DS-567/AMD-AOHW25_620/Demonstrator/hw/PCBs/Motor Encoder Circuit/readme.md

#### Motor Encoder Circuit

Converts the 12V pulses from the rotary encoder to 3.3V which are connected to the FPGA. Test points provide oscilloscope access to the 12V encoder pulses for visualisation.

<p align="center">
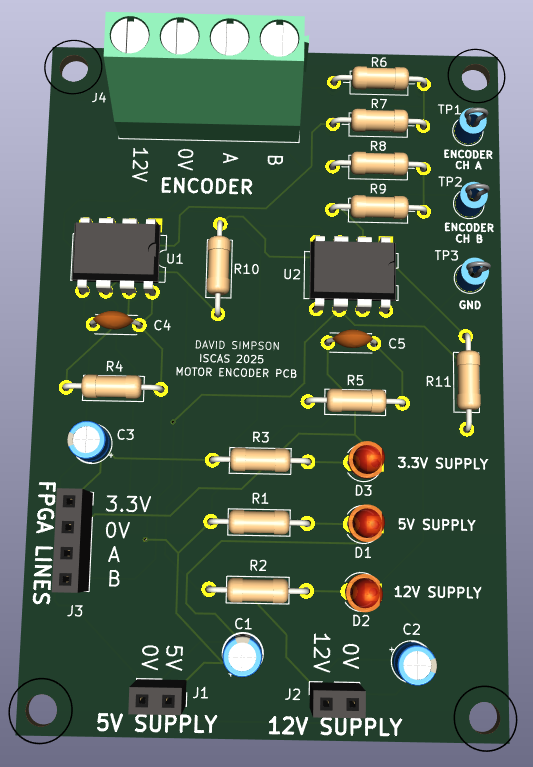
[picture p16: assets/motor_encoder_pcb_3D.PNG]
Motor Encoder pcb 3D
  
</p>

<p align="center">
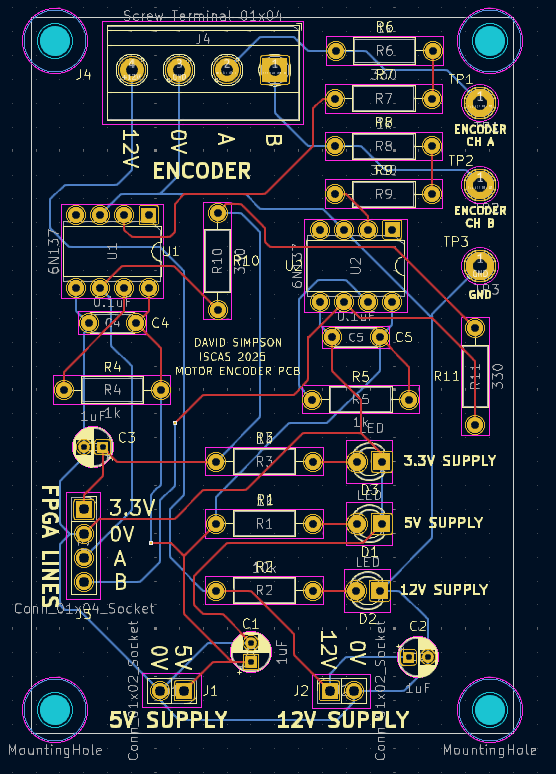
[picture p17: assets/motor_encoder_pcb.PNG]
Motor Encoder pcb
  
</p>
