DS-567/AMD-AOHW25_620/Demonstrator/hw/PCBs/Motor Control Circuit/Readme.md

#### Motor Control Circuit

Allows the user to start, stop and change the direction of the motor using the buttons. A 24-pulse rotary encoder provides motor speed control. LEDs indicates the directional status of motor control, i.e. forward and reveres and also the motor running status. These are all connected to GPIO on the RISC-V processor (Neorv32).

<p align="center">
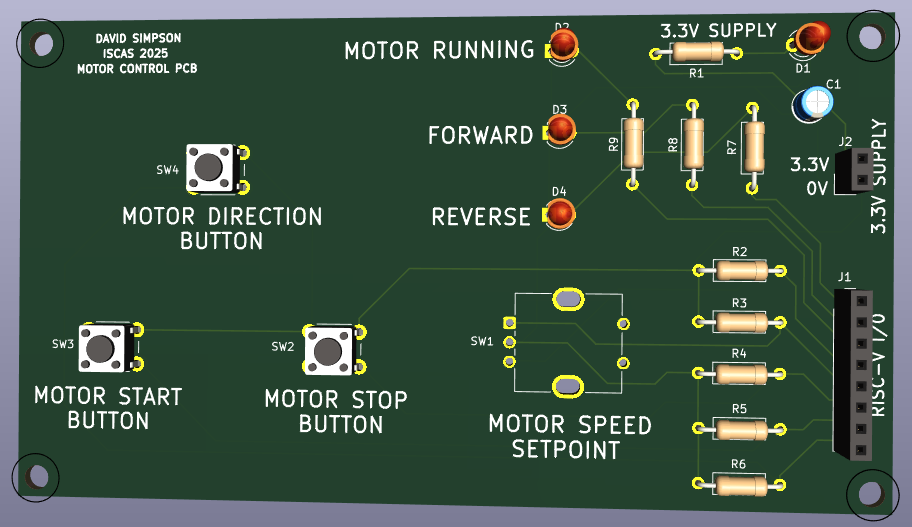
[picture p18: assets/motor_control_pcb_3D.PNG]
Motor Control pcb 3D
  
</p>

<p align="center">
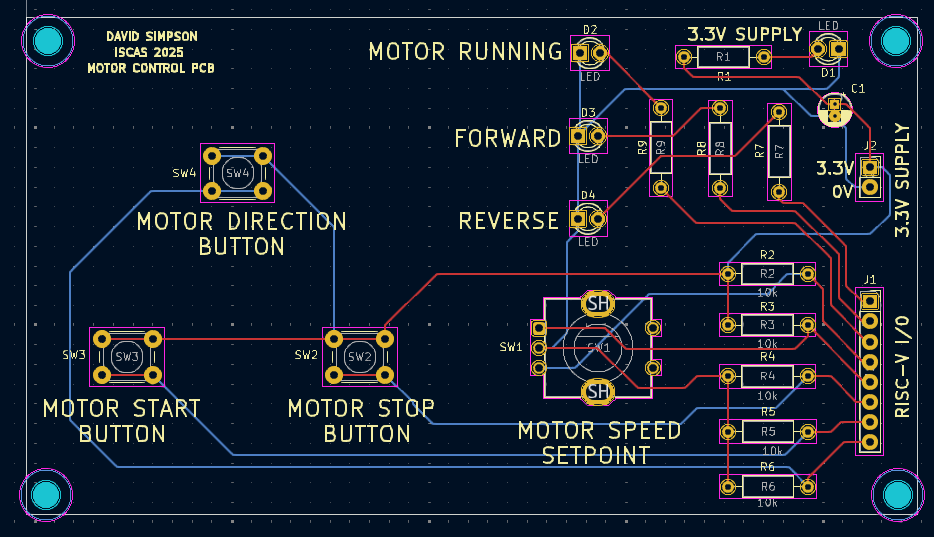
[picture p19: assets/motor_control_pcb.PNG]
Motor Control pcb
  
</p>
