DS-567/AMD-AOHW25_620/Presentation_David_Simpson.pdf

## From Brain-Inspiration to Silicon-Realisation: SNN-based Smart Watchdogs for RISC-V Fault Detection

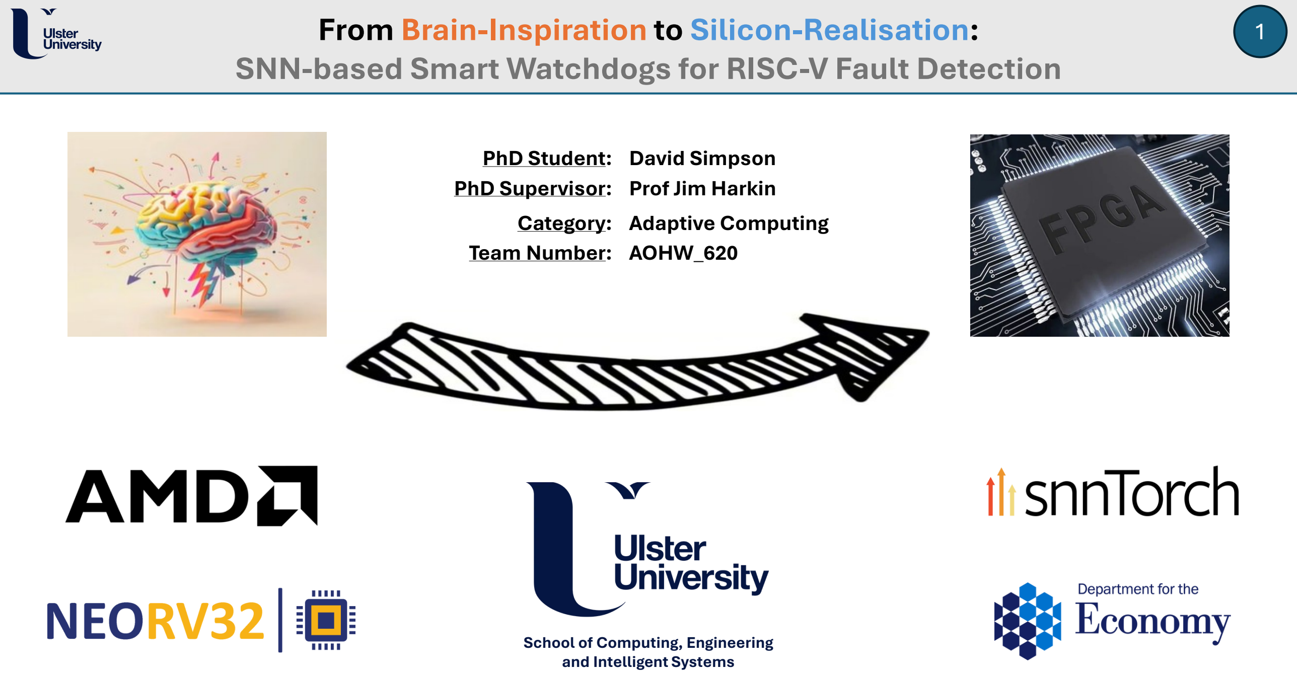
[picture p52: page 1]

1

PhD Student:
PhD Supervisor:
Category:
Team Number:

School of Computing, Engineering and Intelligent Systems

David Simpson
Prof Jim Harkin
Adaptive Computing
AOHW_620

Background and Motivation | 2

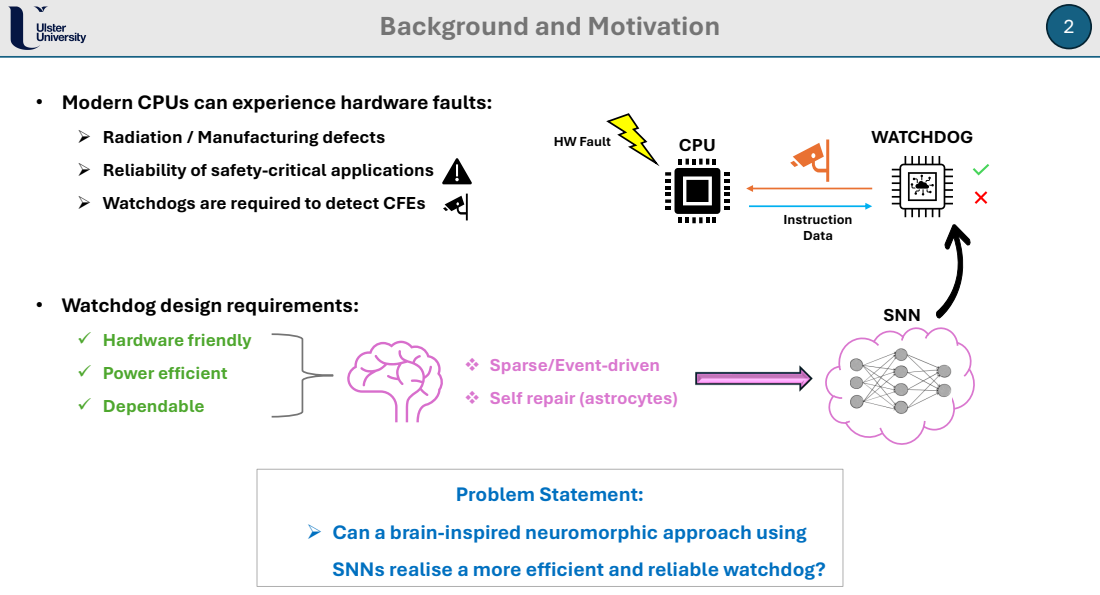
[picture p53: page 2]
HW Fault; CPU; WATCHDOG; Problem Statement:; Instruction Data; SNN

• Modern CPUs can experience hardware faults:
➢ Radiation / Manufacturing defects
➢ Reliability of safety-critical applications
➢ Watchdogs are required to detect CFEs

• Watchdog design requirements:
✓ Hardware friendly
✓ Power efficient
✓ Dependable

❖ Sparse/Event-driven
❖ Self repair (astrocytes)

➢ Can a brain-inspired neuromorphic approach using
SNNs realise a more efficient and reliable watchdog?

Proposed Solution: Smart Watchdogs | 3

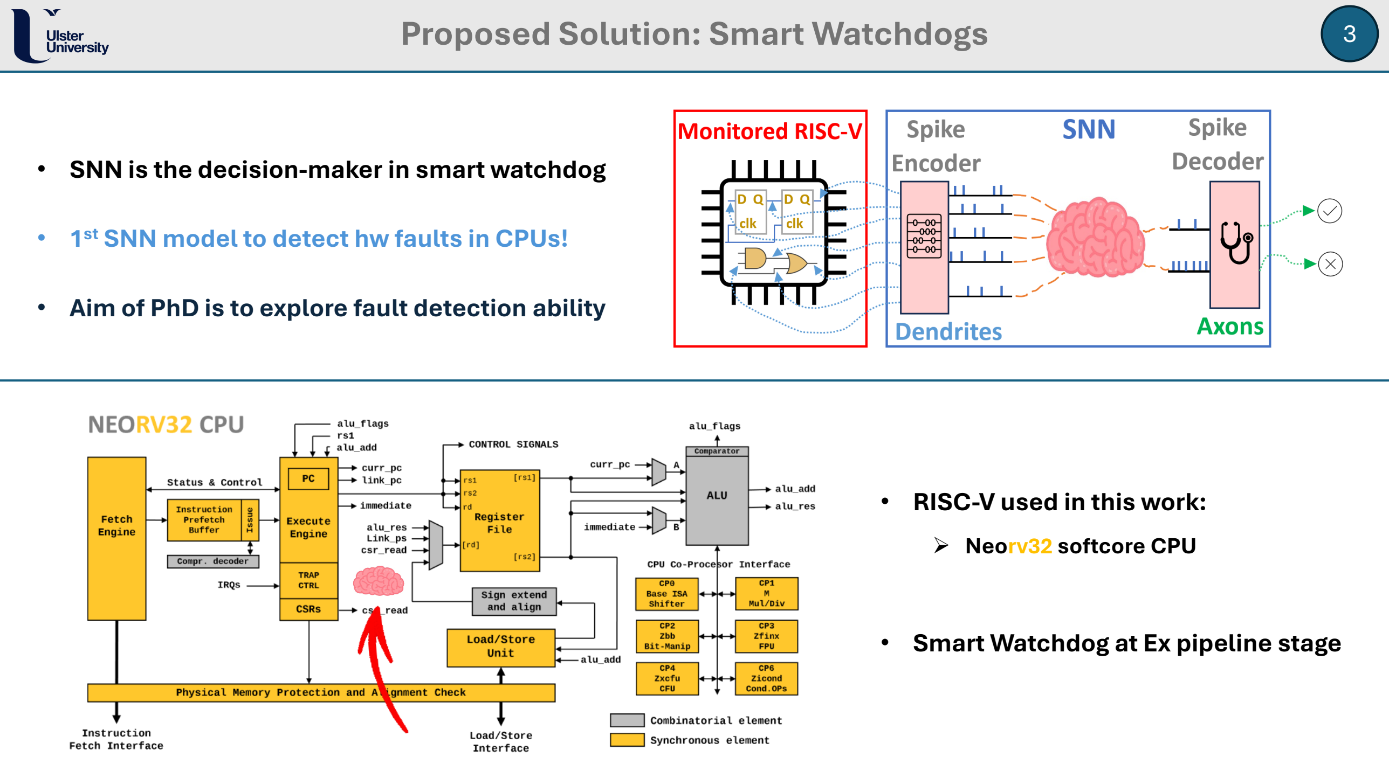
[picture p54: page 3]

- SNN is the decision-maker in smart watchdog
- RISC-V used in this work:
- Neorv32 softcore CPU
- Aim of PhD is to explore fault detection ability
- Smart Watchdog at Ex pipeline stage
- 1

st SNN model to detect hw faults in CPUs!

## Methodology

4

•

8

- Stage Methodology in this PhD ➢ Complete ML Workflow

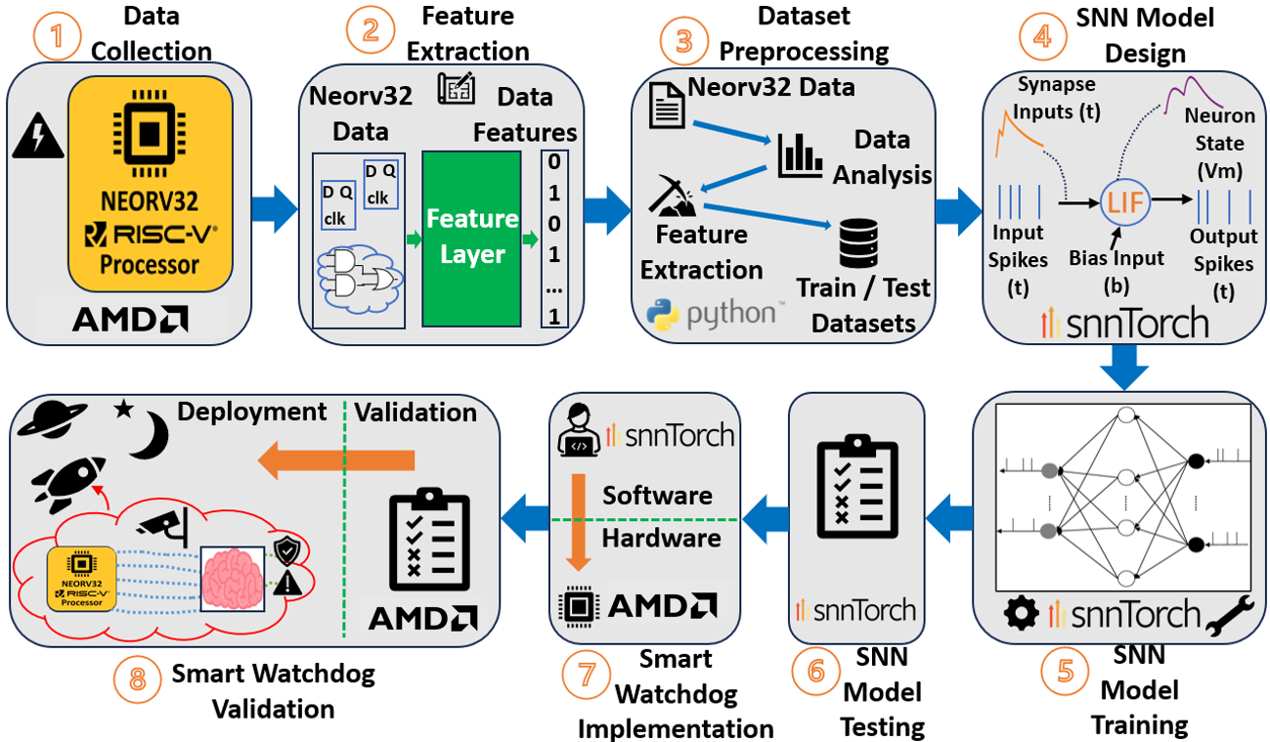
[picture p55: figure]

Key Stages: Data Collection and SNN Model Development | 5

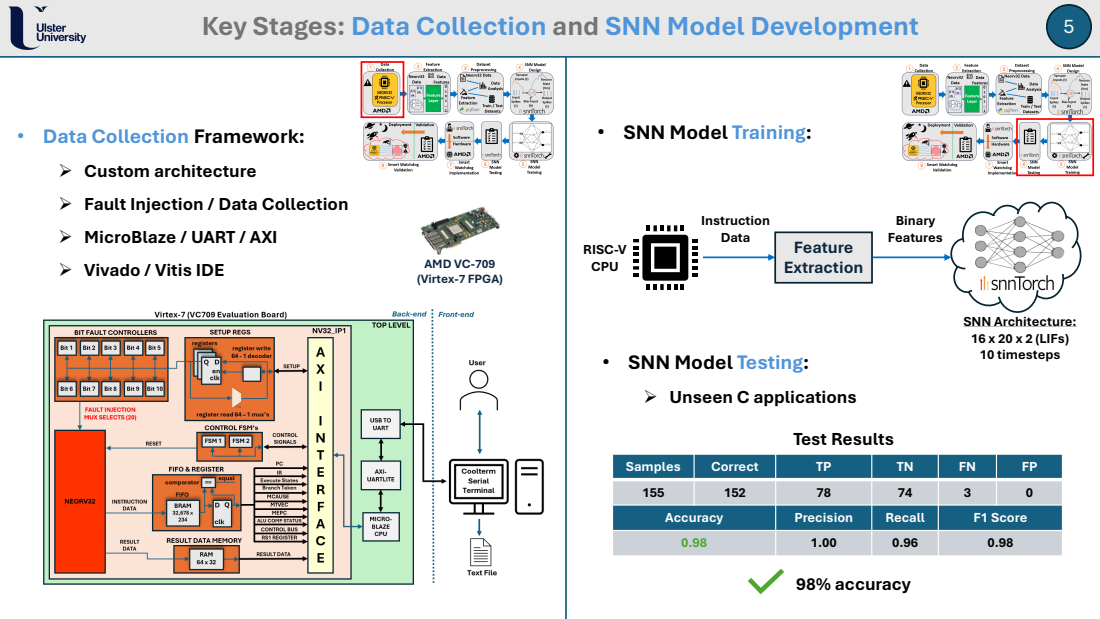
[picture p56: page 5]
➢ Vivado / Vitis IDE; AMD VC-709; (Virtex-7 FPGA); Instruction Data; RISC-V CPU; Feature Extraction; Binary Features; Test Results; 98% accuracy; SNN Architecture: 16 x 20 x 2 (LIFs) 10 timesteps

• Data Collection Framework:
➢ Custom architecture
➢ Fault Injection / Data Collection
➢ MicroBlaze / UART / AXI

• SNN Model Training:

• SNN Model Testing:
➢ Unseen C applications

Samples | Correct | TP | TN | FN | FP
155 | 152 | 78 | 74 | 3 | 0
Accuracy | | Precision | Recall | F1 Score
0.98 | | 1.00 | 0.96 | 0.98

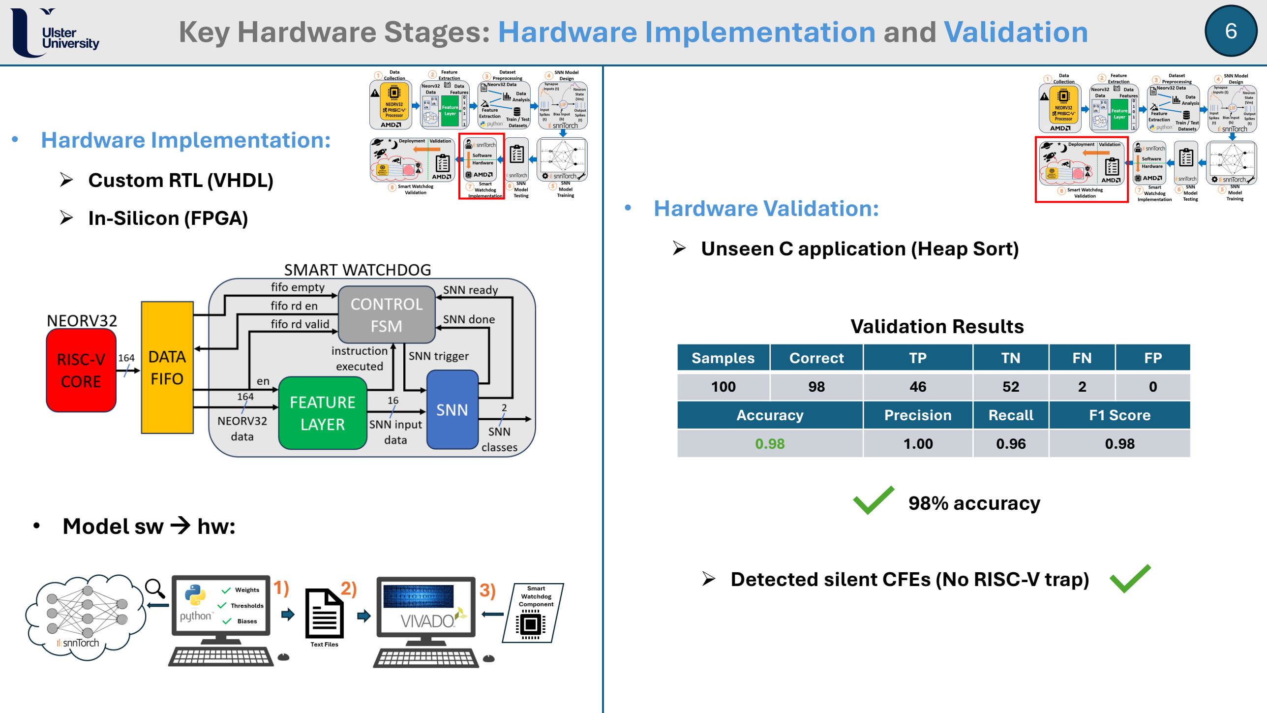
[picture p57: figure]
• Hardware Implementation:; ➢ Custom RTL (VHDL) ➢ In-Silicon (FPGA); Samples; Correct; Accuracy; Precision; Recall; F1 Score; • Model sw → hw:; • Hardware Validation:; ➢ Unseen C application (Heap Sort); Validation Results; 98% accuracy; ➢ Detected silent CFEs (No RISC-V trap)

Key Hardware Stages: Hardware Implementation and Validation | 6

Key Hardware Stages: Demonstrator | 7

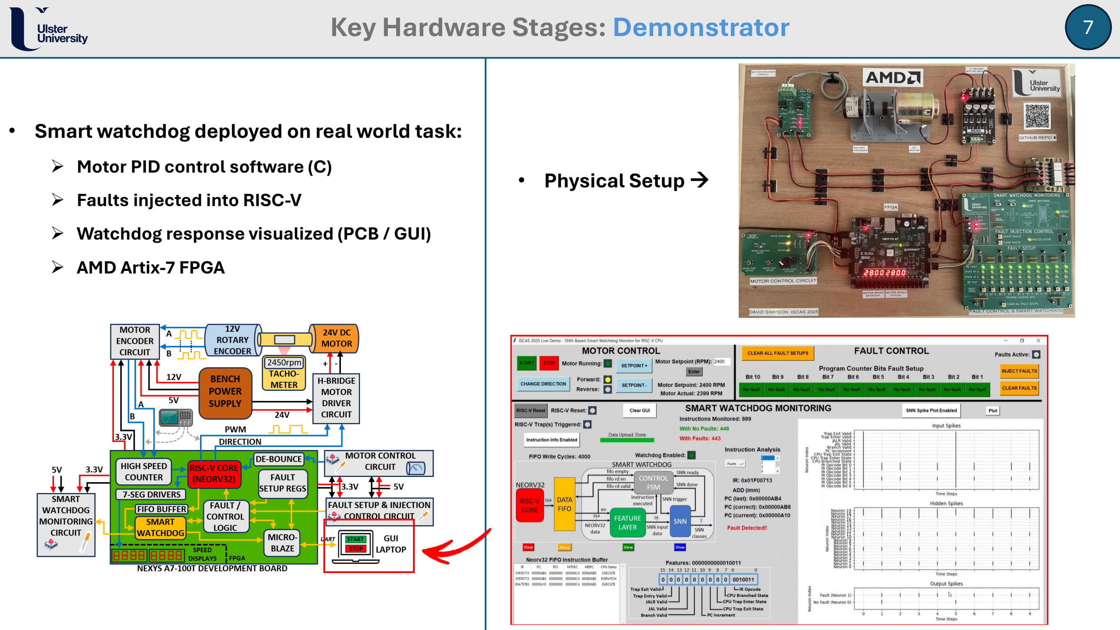
[picture p58: page 7]

- Smart watchdog deployed on real world task:
- Motor PID control software (C)
- Faults injected into RISC-V
- Watchdog response visualized (PCB / GUI)
- AMD Artix-7 FPGA
- Physical Setup →
- Vivado Block Diagram →

PPA / Summary / Future Work | 8

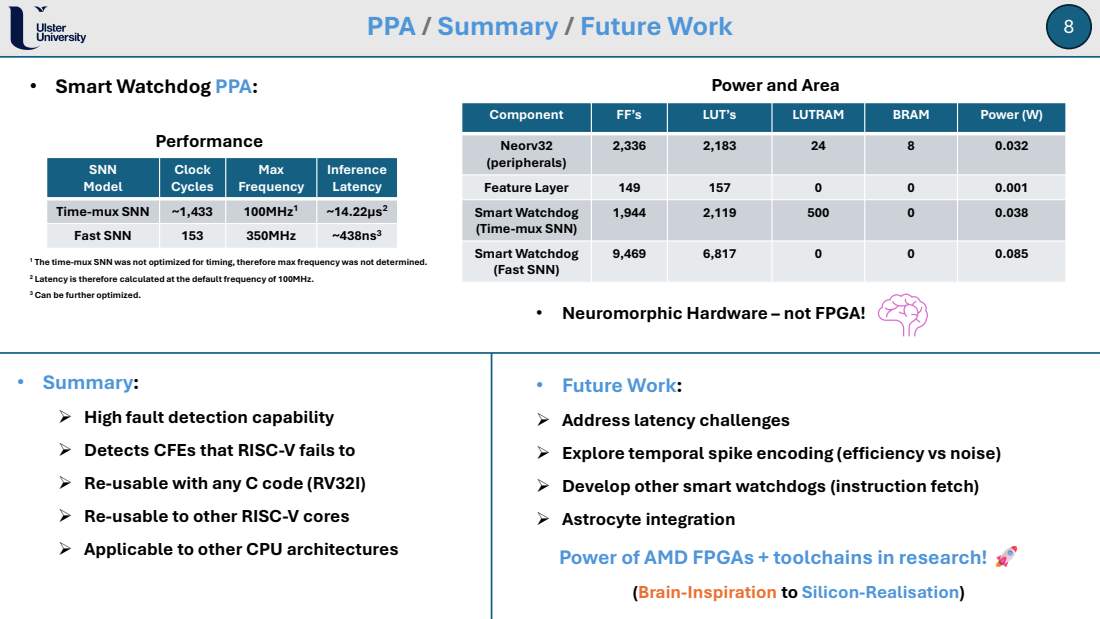
[picture p59: page 8]
Time-mux SNN; 100MHz¹; ~14.22µs²; Fast SNN; 350MHz; ~438ns³; Performance

• Smart Watchdog PPA:

Power and Area

Component | FF’s | LUT’s | LUTRAM | BRAM | Power (W)
Neorv32 (peripherals) | 2,336 | 2,183 | 24 | 8 | 0.032

SNN Model | Clock Cycles | Max Frequency | Inference Latency

Feature Layer | 149 | 157 | 0 | 0 | 0.001

Smart Watchdog
(Time-mux SNN)
(Fast SNN)
• Neuromorphic Hardware – not FPGA!

1 The time-mux SNN was not optimized for timing, therefore max frequency was not determined.
2 Latency is therefore calculated at the default frequency of 100MHz.
3 Can be further optimized.

• Summary:
➢ High fault detection capability
➢ Detects CFEs that RISC-V fails to
➢ Re-usable with any C code (RV32I)
➢ Re-usable to other RISC-V cores
➢ Applicable to other CPU architectures

• Future Work:
➢ Address latency challenges
➢ Explore temporal spike encoding (efficiency vs noise)
➢ Develop other smart watchdogs (instruction fetch)
➢ Astrocyte integration
Power of AMD FPGAs + toolchains in research!

(Brain-Inspiration to Silicon-Realisation)

## Time for Questions ?

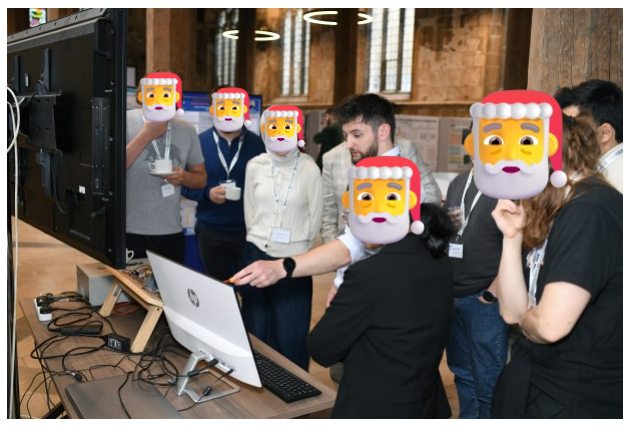
[picture p60: figure]
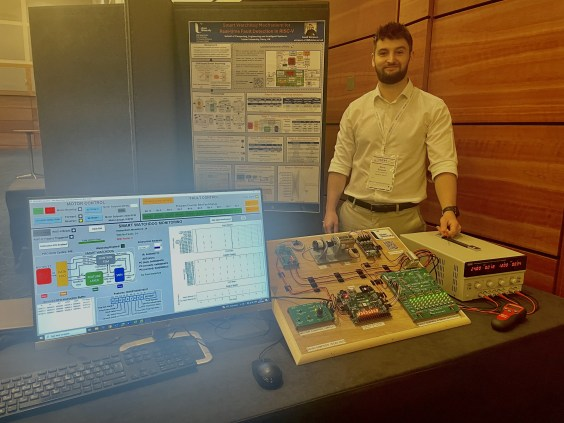
[picture p61: figure]

IEEE ISCAS 2025

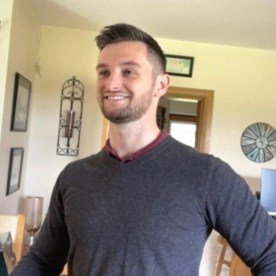
[picture p62: figure]

International
Workshop on
Reliable and
Sustainable
Neuromorphic
Hardware 2025

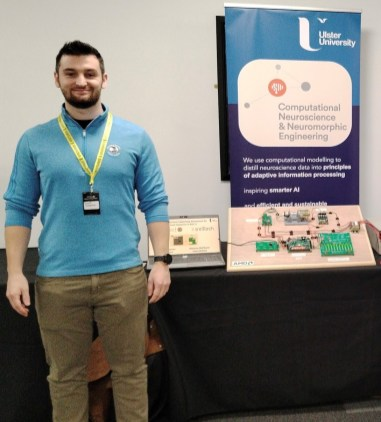
[picture p63: figure]

AMD / eFutures
Edge AI 2024

Contacts:

simpson-d12@ulster.ac.uk

David Simpson | LinkedIn (https://www.linkedin.com/in/david-simpson-040189221/)

Github repo:DS- (https://github.com/DS-567/AMD-AOHW25_620)567/AMD- (https://github.com/DS-567/AMD-AOHW25_620)AOHW25_620: AMD Open Hardware Design Competition 2025 Contribution: SNN- (https://github.com/DS-567/AMD-AOHW25_620)based Smart Watchdogs for RISC- (https://github.com/DS-567/AMD-AOHW25_620)V Fault Detection (https://github.com/DS-567/AMD-AOHW25_620)

Thanks once again to AMD and Stephan Nolting!

And congrats to all winners! ☺

Live Demos

9
