DS-567/AMD-AOHW25_620/Reference_SNN_HDL/README.md

# Time-multiplexing SNN HDL Code

⚠️ **Note**, make sure to use the Python script for the SNN and not the Fast SNN when building the setup text files as descibed in `AMD-AOHW25_620
/Model_sw_to_hw/`

See the [report](../Report.pdf) for full details on the SNN implementation.
