DS-567/AMD-AOHW25_620/Demonstrator/sw/Python_GUI/images/Feature layer img.PNG

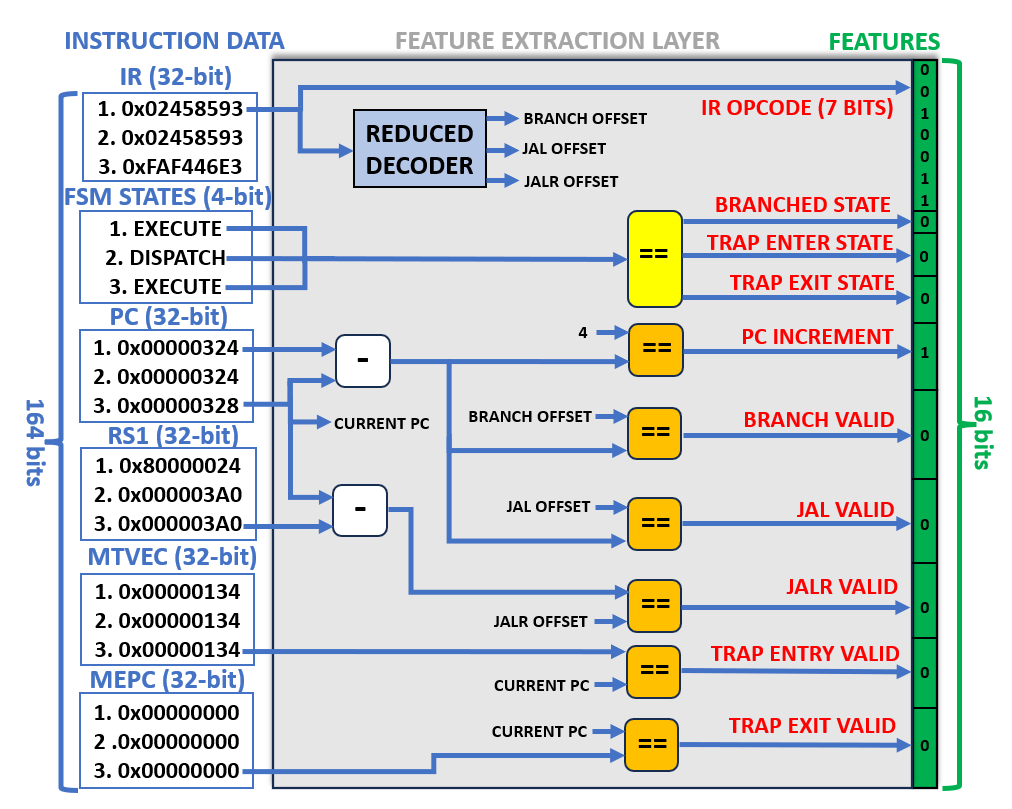
Demonstrator/sw/Python_GUI/images/Feature layer img.PNG
