DS-567/AMD-AOHW25_620/Demonstrator/sw/Python_GUI/images/neorv32.png

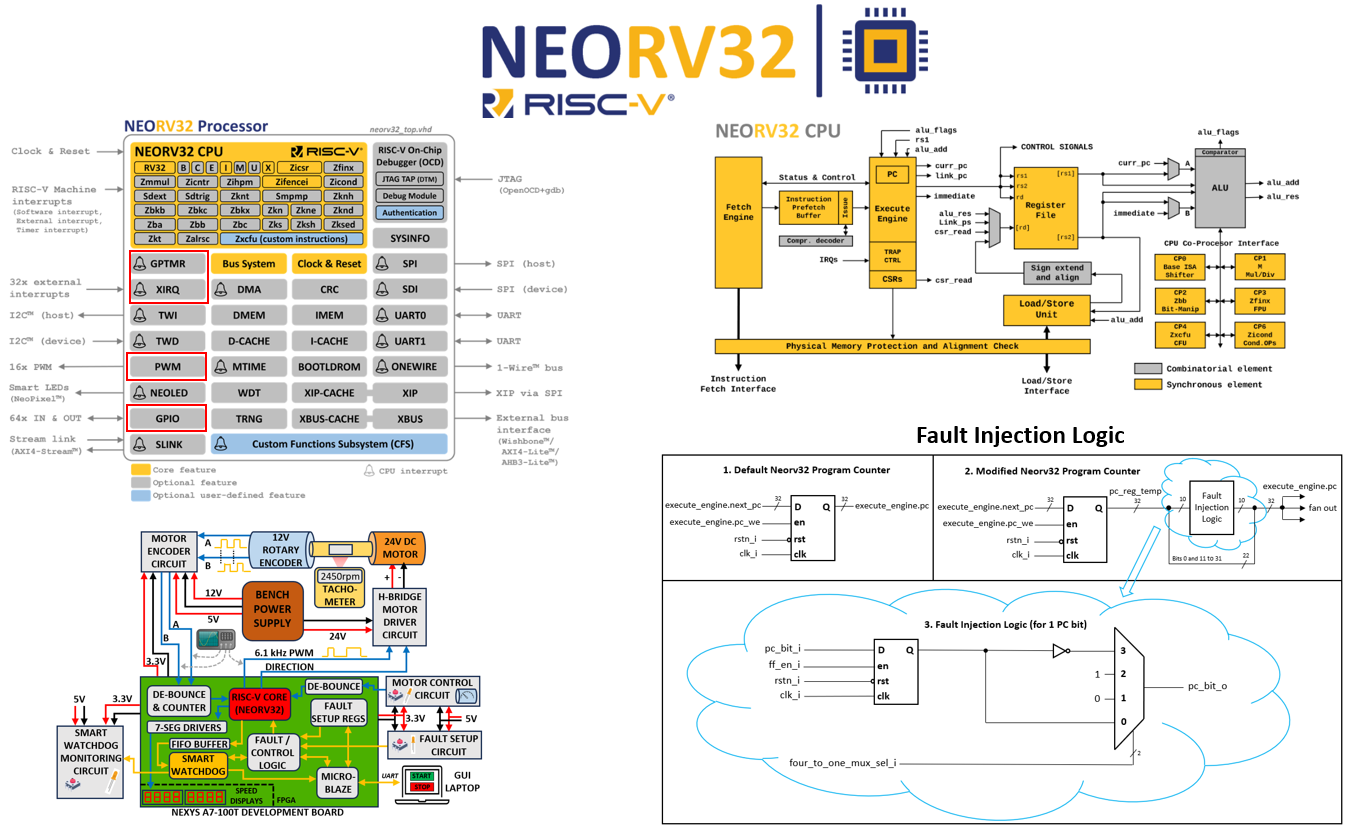
Demonstrator/sw/Python_GUI/images/neorv32.png
