DS-567/AMD-AOHW25_620/Demonstrator/sw/Python_GUI/images/snn 2.PNG

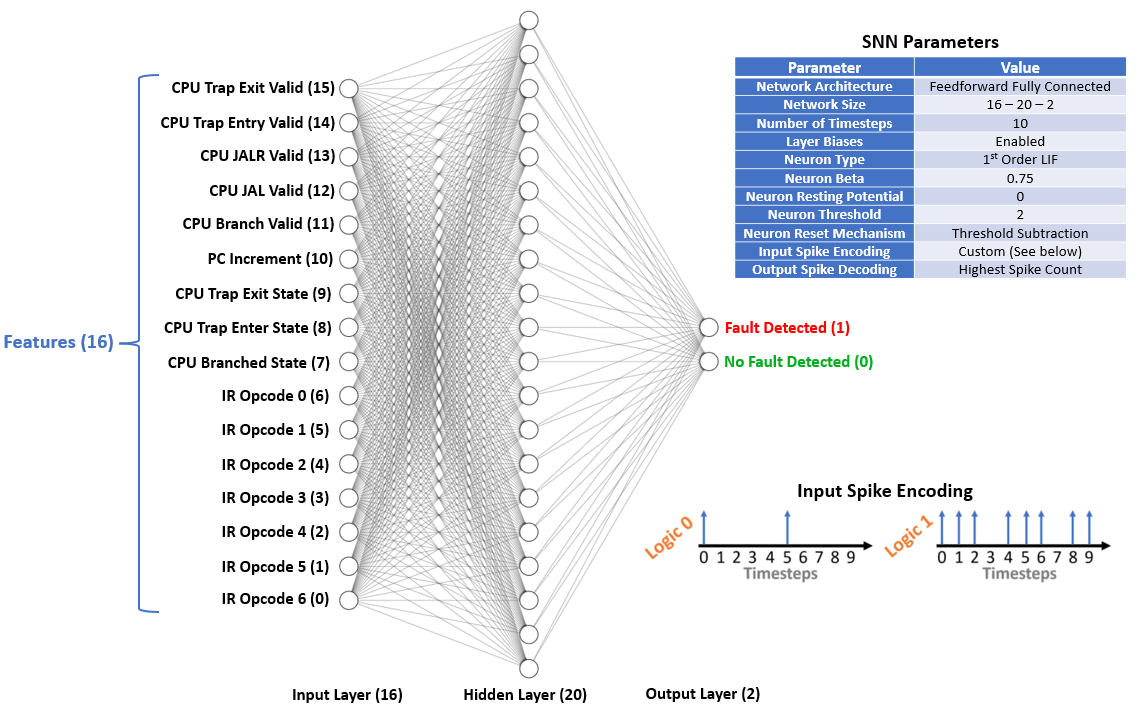
Demonstrator/sw/Python_GUI/images/snn 2.PNG
