DS-567/AMD-AOHW25_620/Demonstrator/hw/PCBs/Motor Encoder Circuit/Schematic.pdf

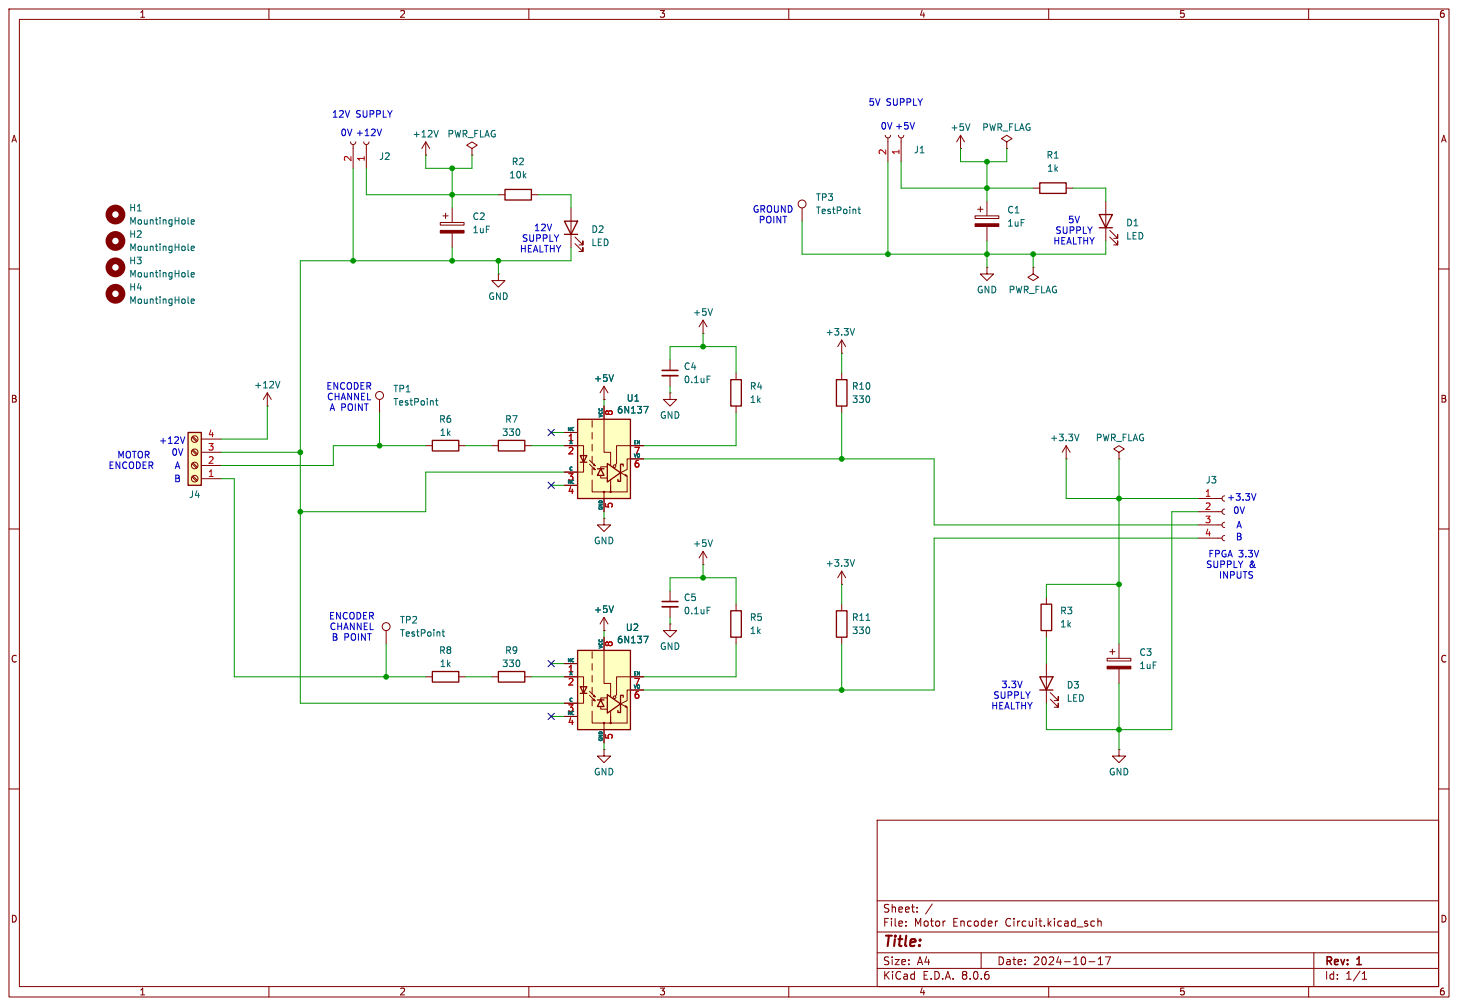
[picture p72: page 1]

1k H4 MountingHole H1 MountingHole H2 MountingHole H3 MountingHole
