DS-567/AMD-AOHW25_620/Demonstrator/hw/PCBs/Motor Control Circuit/Schematic.pdf

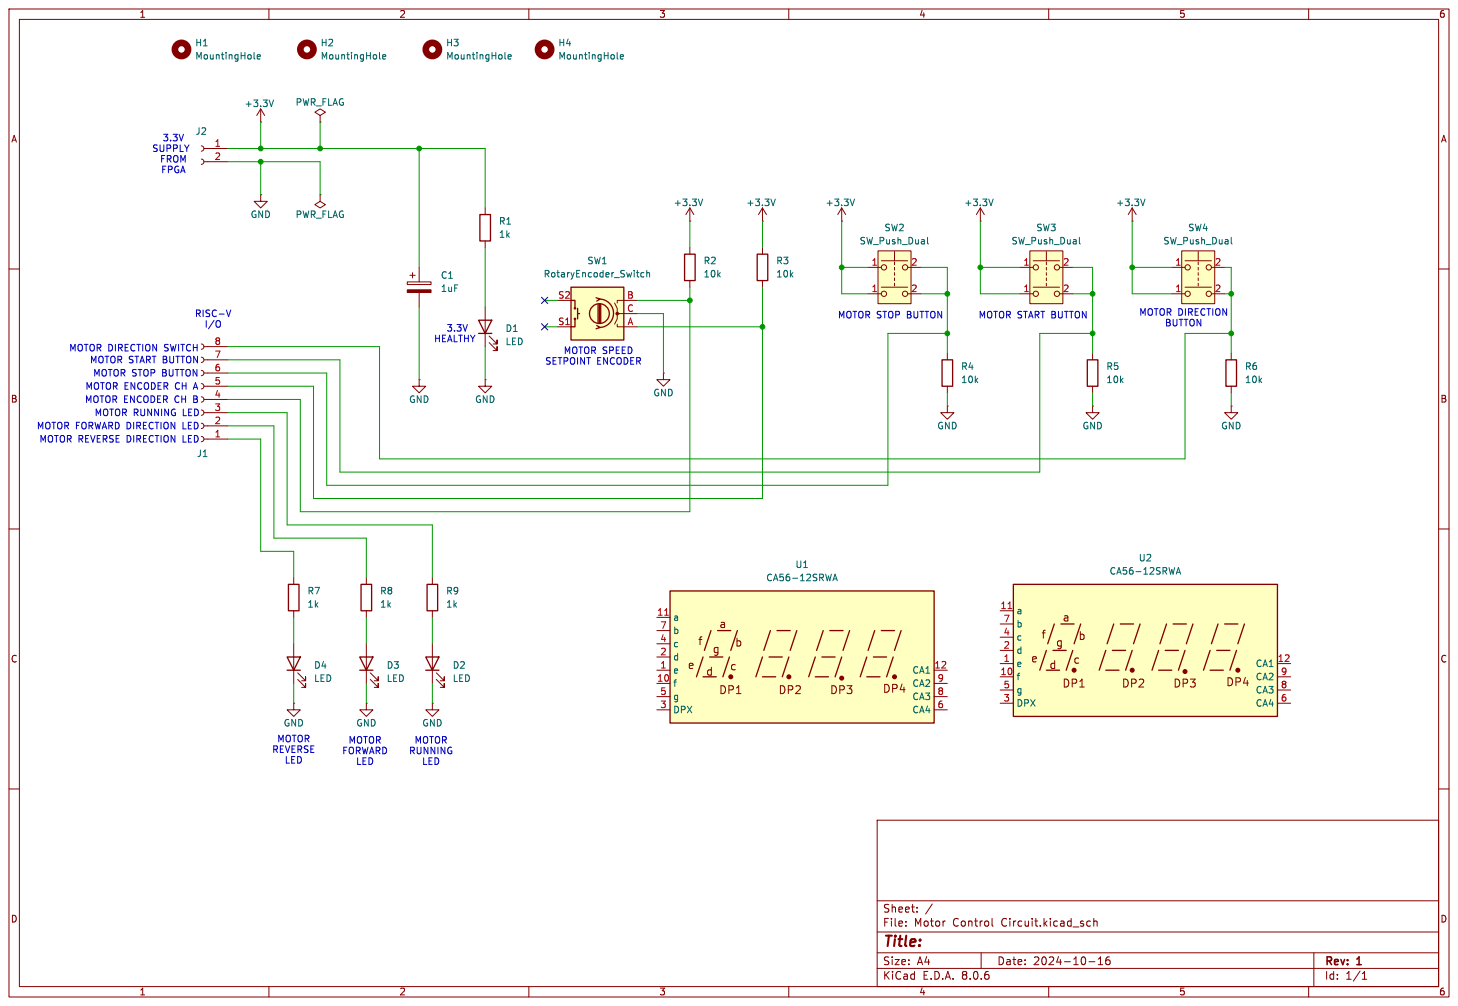
[picture p74: page 1]
