DS-567/AMD-AOHW25_620/(commit log)

2025-08-28 Create Motor Control
2025-08-28 Create Motor Encoder PCB
2025-08-28 Create Motor Control PCB
2025-08-28 Create Fault Injection and Smart Watchdog Monitoring PCB
